proyectoitsv/2026_Auravis/feedback.md

# Investigación sobre perros de alerta médica

## Validación y competencia

### El perro como validador

Se destaca que el comportamiento de los perros entrenados puede servir como referencia para validar el método del proyecto.

Estos perros son capaces de anticipar un episodio aproximadamente **12 segundos antes** de que ocurra y suelen manifestarlo sentándose o realizando una conducta previamente entrenada.

El objetivo del dispositivo tecnológico es replicar esa misma capacidad de anticipación, pero de forma **electrónica, portátil y reproducible**.

### Mecanismo de detección

Se discutió qué tipo de señal detecta el animal y cómo se diferencia del enfoque del proyecto.

- **Dispositivo del proyecto:** mide la **conductancia de la piel**, asociada a la sudoración producida por la activación del sistema nervioso simpático. Esta medición se realiza mediante electrodos.
- **Perro entrenado:** detecta un cambio químico u olor específico, posiblemente asociado a un gas o compuesto disuelto en el aire.

### Próximos pasos

Se propuso avanzar con las siguientes acciones:

- Contactar a entrenadores de perros de alerta médica para comprender qué conductas se entrenan exactamente y qué señales se utilizan.
- Investigar qué componente químico cambia en el olor corporal antes de un episodio.
- Evaluar si ese componente podría detectarse mediante un **sensor de gases**.
- Contactar a un médico mencionado en Instagram que realiza mediciones de **bioimpedancia** y **fatiga muscular**, como posible fuente de consulta técnica o médica.

# Revisión de estadísticas y contexto en el informe

Se corrigió el análisis de un dato estadístico del informe.

De las lesiones físicas anuales registradas, el **26,5%** son causadas en personas por episodios relacionados con la epilepsia.

También se remarcó la importancia de incluir el número total absoluto de la población afectada, es decir, el **“n” total**, para dar contexto real a los porcentajes.

Por ejemplo, un 26,5% no tiene el mismo peso si el total corresponde a **100 personas** que si corresponde a **100.000 personas**.

# Continuidad y antecedentes: proyecto de Tommy

Se señaló que es fundamental explicitar en el informe que el trabajo actual toma como base el proyecto anterior de **Tommy**.

Esto implica que el equipo no parte desde cero, sino que utiliza como input elementos ya desarrollados, como:

- código;
- carcasas;
- decisiones técnicas previas;
- aprendizajes obtenidos durante el proyecto anterior.

El objetivo actual es continuar esa línea de trabajo y mejorar el desarrollo existente.

Uno de los estudiantes mencionó que, en concordancia con el informe final de Tommy, se descartó un sensor basado en **fotopletismografía**, utilizado para medir saturación de oxígeno, porque no entregaba resultados adecuados. Esto obligó al equipo a cambiar de componente.

# Nombre del dispositivo y registro de marca

## Elección del nombre

Se discutieron dudas sobre el nombre del dispositivo. Entre las opciones mencionadas aparecen nombres como **“Nacho”**, **“Michi”** o posibles siglas.

Se recomendó no dedicar demasiado tiempo a buscar un significado excesivamente profundo, literal o técnico para el nombre.

Como referencia, se mencionaron marcas como **Apple**, **Coca-Cola** u **Omixom**, cuyos nombres no necesariamente describen de forma directa lo que hace la empresa o el producto.

## Protección legal

Se remarcó como punto clave registrar la marca dentro del marco jurídico correspondiente una vez definido el nombre.

La advertencia principal fue evitar avanzar con el desarrollo, invertir dinero y luego descubrir que el nombre no puede utilizarse porque ya está registrado por otra persona o empresa.

También se mencionaron posibles conflictos legales por:

- similitud fonética;
- similitud dentro del mismo rubro;
- uso en clases o categorías comerciales relacionadas.

El trámite de registro puede realizarse de forma personal o mediante un gestor, pero se recomienda analizar cuidadosamente las **clases y categorías del mercado** que se desea proteger.
