proyectoitsv/2026_Auravis/Modelos 3d/Carcasas/Case_Auravis-V4.SLDPRT

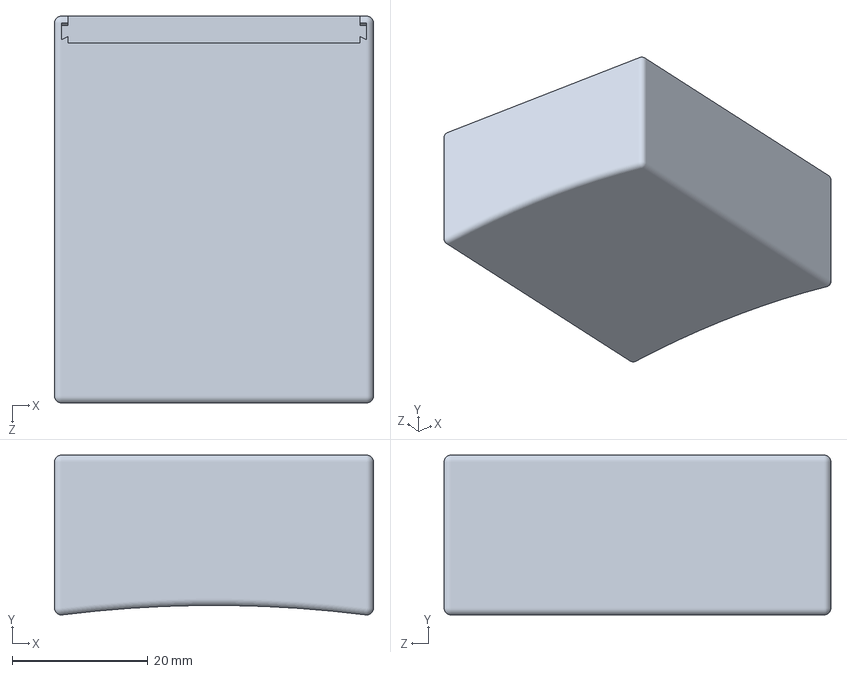
[picture p1: CAD file, 2026-09-07]
Modelos 3d/Carcasas/Case_Auravis-V4.SLDPRT
47.0 x 23.6 x 57.0 mm
