proyectoitsv/2026_Auravis/Modelos 3d/Tapas/Tapa-Auravis.SLDPRT

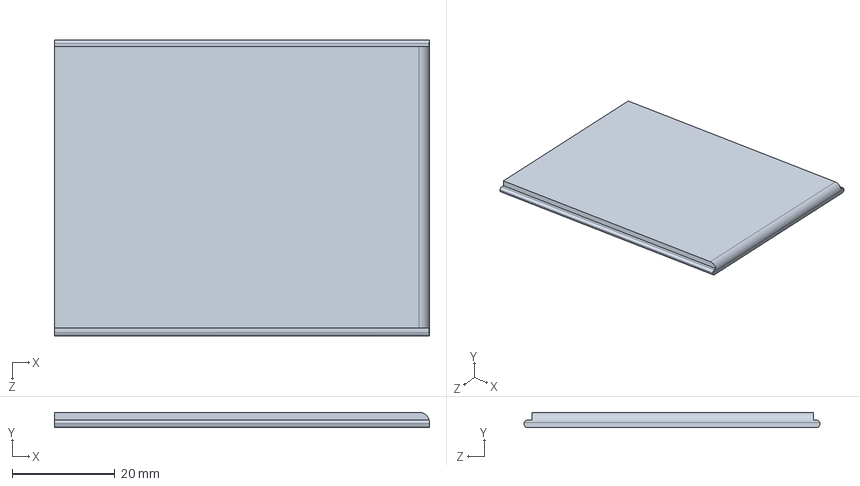
[picture p2: CAD file, 2026-09-07]
Modelos 3d/Tapas/Tapa-Auravis.SLDPRT
73.0 x 3.00 x 57.6 mm
