proyectoitsv/2026_Auravis/Modelos 3d/Carcasas/Case_Auravis- V1.SLDPRT

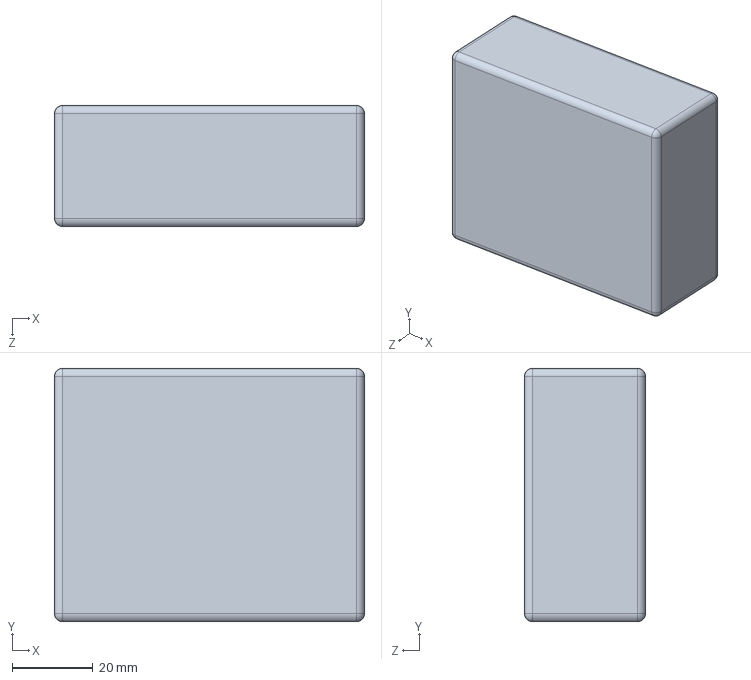
[picture p3: CAD file, 2026-09-07, an earlier design]
Modelos 3d/Carcasas/Case_Auravis- V1.SLDPRT
76.9 x 62.8 x 30.0 mm
