proyectoitsv/2026_Auravis/Modelos 3d/Carcasas/Case_Auravis-V3.SLDPRT

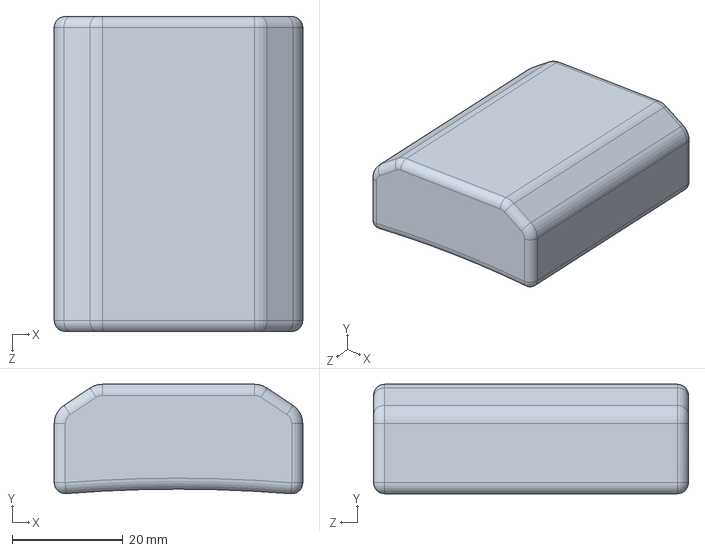
[picture p4: CAD file, 2026-09-07, an earlier design]
Modelos 3d/Carcasas/Case_Auravis-V3.SLDPRT
45.0 x 19.8 x 57.0 mm
