proyectoitsv/2026_Auravis/Modelos 3d/Carcasas/Case_Auravis-V2.SLDPRT

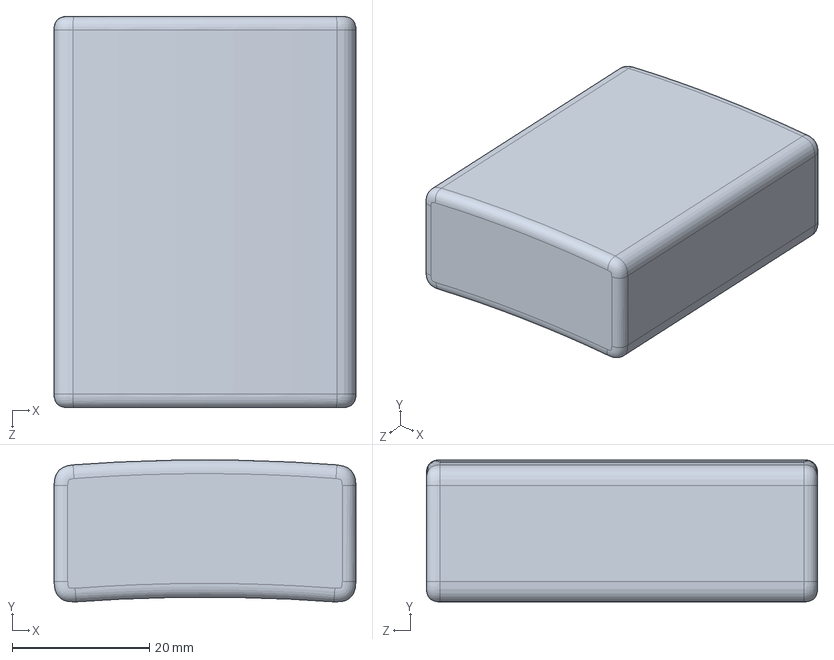
[picture p5: CAD file, 2026-09-07, an earlier design]
Modelos 3d/Carcasas/Case_Auravis-V2.SLDPRT
44.0 x 20.7 x 57.0 mm
