proyectoitsv/2026_Auravis/(commit log)

2026-05-18 Agrega archivo de feedback
2026-09-07 Sube carpeta <Contextos para ia> V1
2026-09-07 Sube carpeta <Modelos 3d> V1
    [Case_Auravis- V1.SLDPRT, Case_Auravis-V2.SLDPRT, Case_Auravis-V3.SLDPRT, Tapa-Auravis.SLDPRT]
2026-09-07 Sube <Case_Auravis-V4>
    [Case_Auravis-V4.SLDPRT]
2026-10-14 Sube carpeta KiCads V1
2026-10-14 Sube carpeta <Datasheets sensores>
2026-10-14 Cambia el nombre de la carpeta <Datasheets sensores> a <Datasheets>
